oppo-chan/Two-Stage-CMOS-Op-Amp/lvs/amp_remake.asc

C1: CAP_MIN; 1.656p
C2: CAP_MIN; 0.414p
C3: CAP_MIN; 0.414p
C4: CAP_MIN; 0.414p
C5: CAP_MIN; 0.414p
C6: CAP_MIN; 0.414p
C7: CAP_MIN; 0.414p
C8: CAP_MIN; 0.414p
C9: CAP_MIN; 0.414p
C10: CAP_MIN; 0.414p
C11: CAP_MIN; 0.414p
C12: CAP_MIN; 0.414p
C13: CAP_MIN; 0.414p
M1: PMOS_MIN; l=10u w=40u m=2
M2: PMOS_MIN; l=10u w=40u m=2
M3: NMOS_MIN; l=10u w=10u m=1
M4: NMOS_MIN; l=10u w=10u m=1
M5: PMOS_MIN; l=10u w=40u m=8
M6: NMOS_MIN; l=10u w=10u m=4
M7: NMOS_MIN; l=10u w=10u m=2
M8: NMOS_MIN; l=10u w=10u m=4
M9: PMOS_MIN; l=10u w=40u m=1
M10: PMOS_MIN; l=10u w=40u m=1
M11: PMOS_MIN; l=10u w=40u m=1
M12: PMOS_MIN; l=10u w=40u m=1
M13: NMOS_MIN; l=10u w=10u m=1
M14: NMOS_MIN; l=10u w=10u m=1
M15: NMOS_MIN; l=10u w=10u m=1
M16: NMOS_MIN; l=10u w=10u m=1
R1: RES_MIN; 36k
R11: RES_MIN; 3.6k
R12: RES_MIN; 3.6k
R13: RES_MIN; 3.6k
R14: RES_MIN; 3.6k
R15: RES_MIN; 3.6k
R16: RES_MIN; 3.6k
R17: RES_MIN; 3.6k
R18: RES_MIN; 3.6k
R19: RES_MIN; 3.6k
R20: RES_MIN; 3.6k
R21: RES_MIN; 3.6k
R22: RES_MIN; 3.6k
R23: RES_MIN; 3.6k
R24: RES_MIN; 3.6k
R25: RES_MIN; 3.6k
R26: RES_MIN; 3.6k
R27: RES_MIN; 3.6k
R28: RES_MIN; 3.6k
R29: RES_MIN; 3.6k
R30: RES_MIN; 3.6k
R31: RES_MIN; 3.6k
R32: RES_MIN; 3.6k
Named nets: OUT, VDD, VSS, INM, IMP
.include "C:\\Users\\michioto\\KLayout\\salt\\ICPS2023_5\\Technology\\tech\\models\\SOI_CMOS"
